SKNMIPSA/elektronicy-p-lodz-pl-2018/_PHOTOS/bottom.jpg

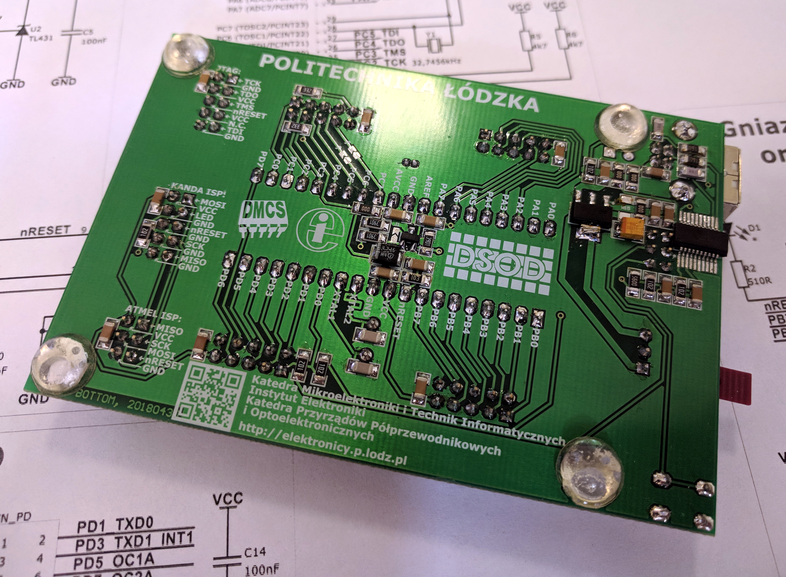
_PHOTOS/bottom.jpg
