SKNMIPSA/elektronicy-p-lodz-pl-2018/_PHOTOS/top1.jpg

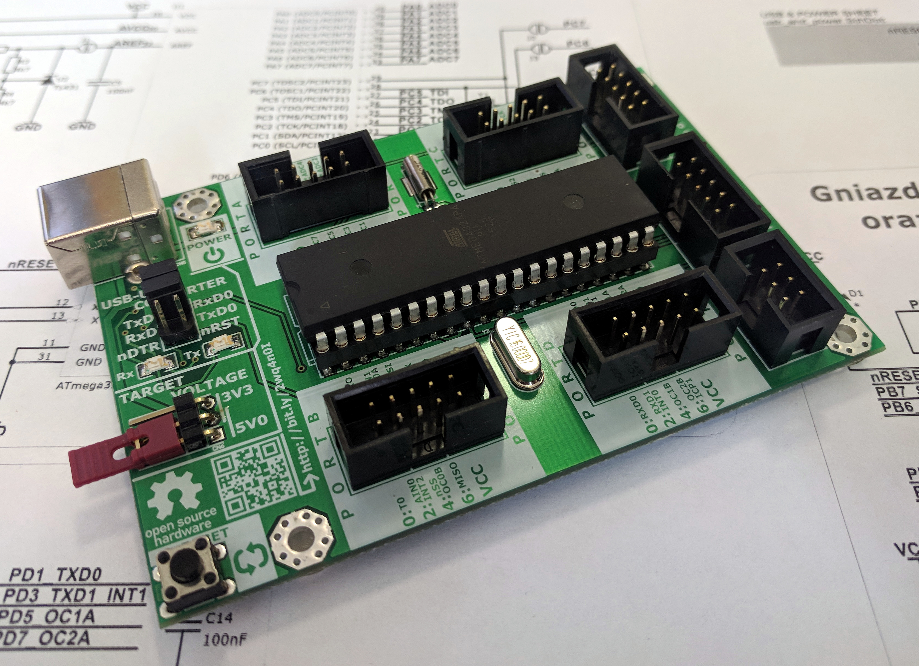
_PHOTOS/top1.jpg
