SKNMIPSA/elektronicy-p-lodz-pl-2018/README.md

# elektronicy-p-lodz-pl-2018
Płytka prototypowa rozdawana podczas wydarzenia 'Elektronicy dla studentów': IE, DMCS i DSOD PŁ - 2018
