SKNMIPSA/elektronicy-p-lodz-pl-2018/_PHOTOS/top2.jpg

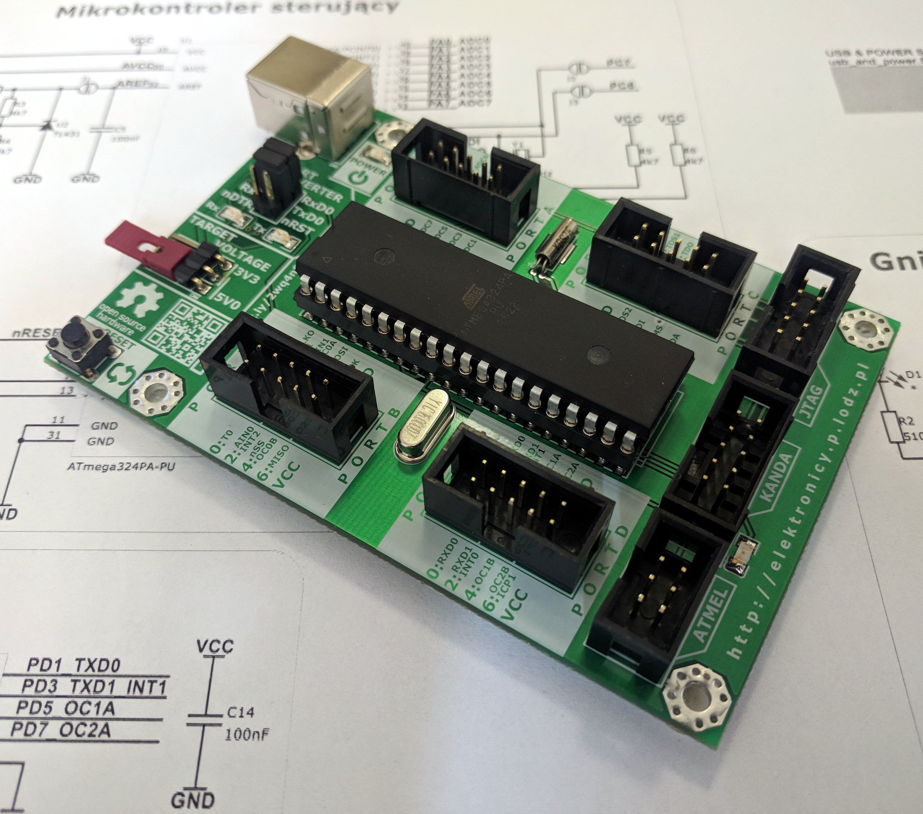
_PHOTOS/top2.jpg
