SKNMIPSA/elektronicy-p-lodz-pl-2018/_PHOTOS/top3.jpg

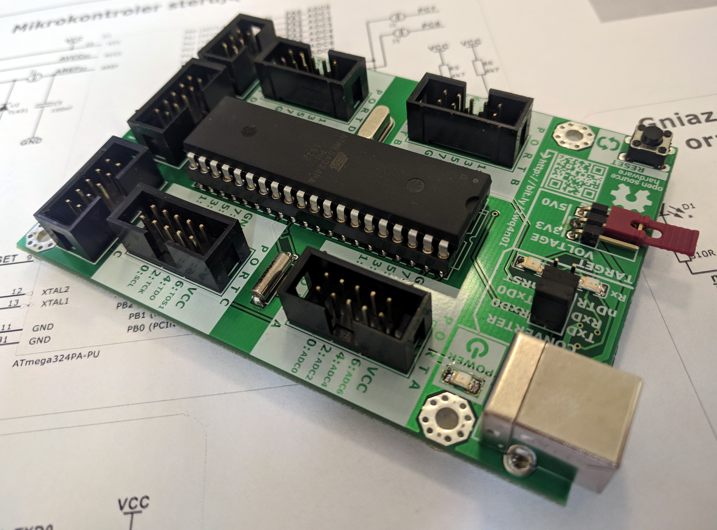
_PHOTOS/top3.jpg
