SKNMIPSA/elektronicy-p-lodz-pl-2018/_PHOTOS/top4.jpg

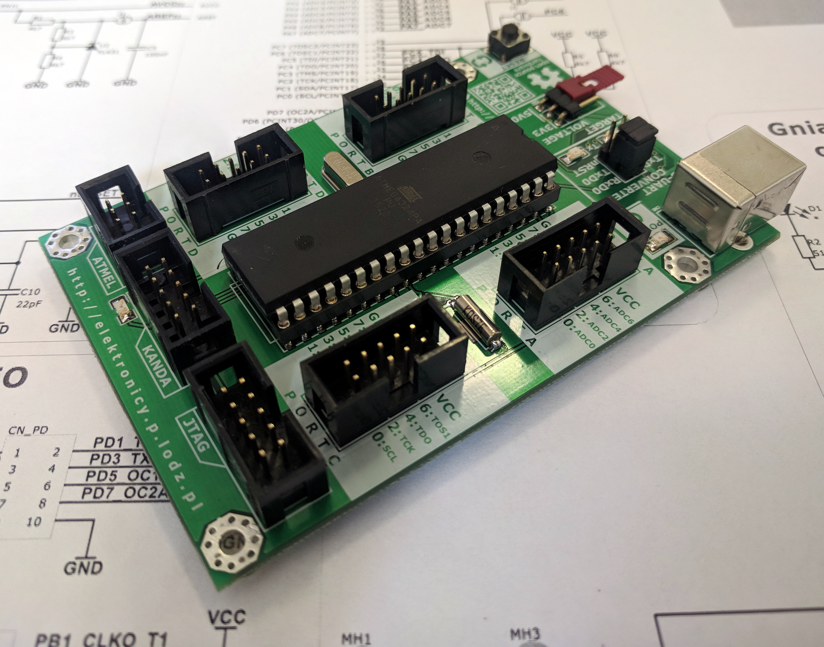
_PHOTOS/top4.jpg
