SKNMIPSA/elektronicy-p-lodz-pl-2018/bottom.png

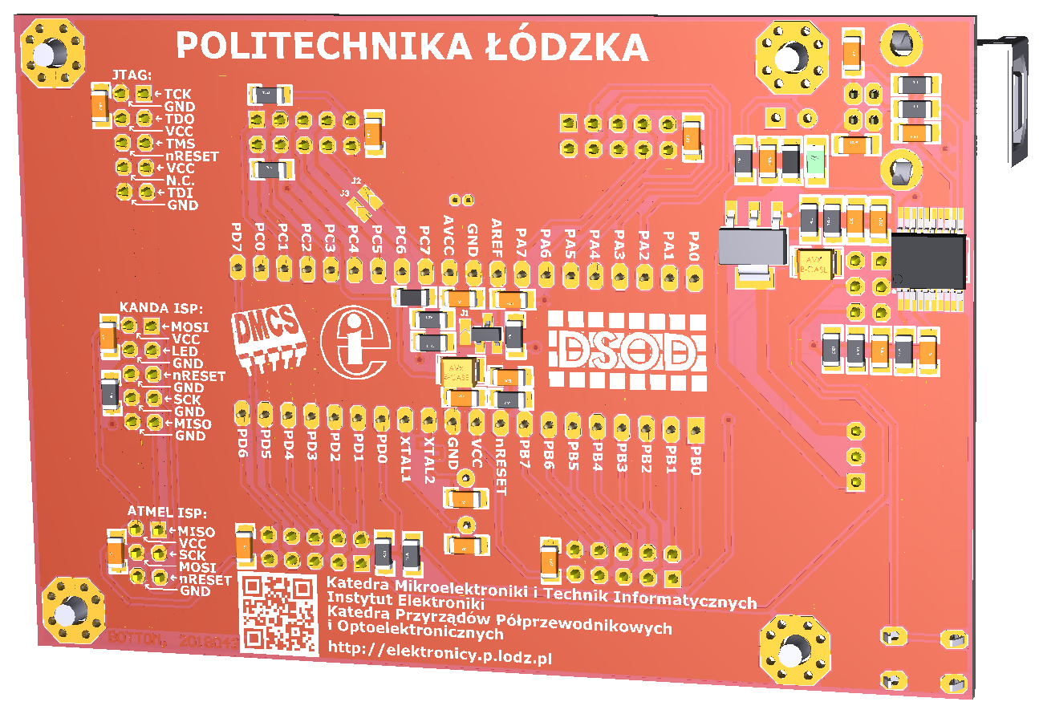
bottom.png
