SKNMIPSA/elektronicy-p-lodz-pl-2018/top.png

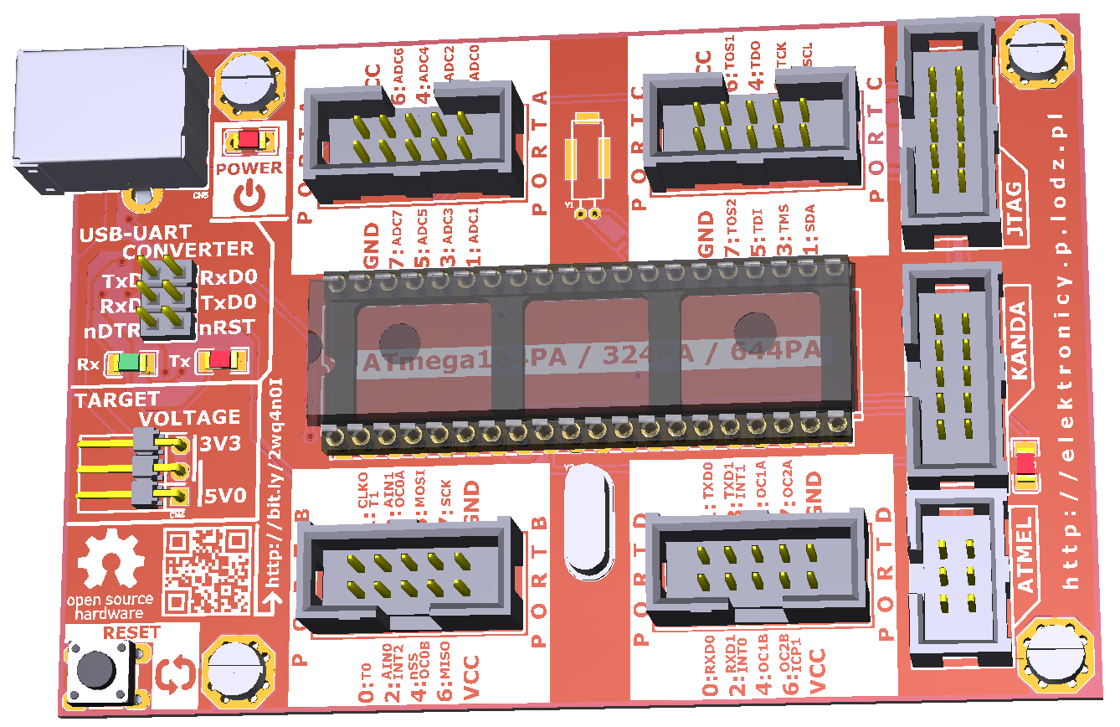
top.png
