SKNMIPSA/elektronicy-p-lodz-pl-2018/_DOCUMENTATION/sch, elektronicy-p-lodz-pl-B-2018, FULL.pdf

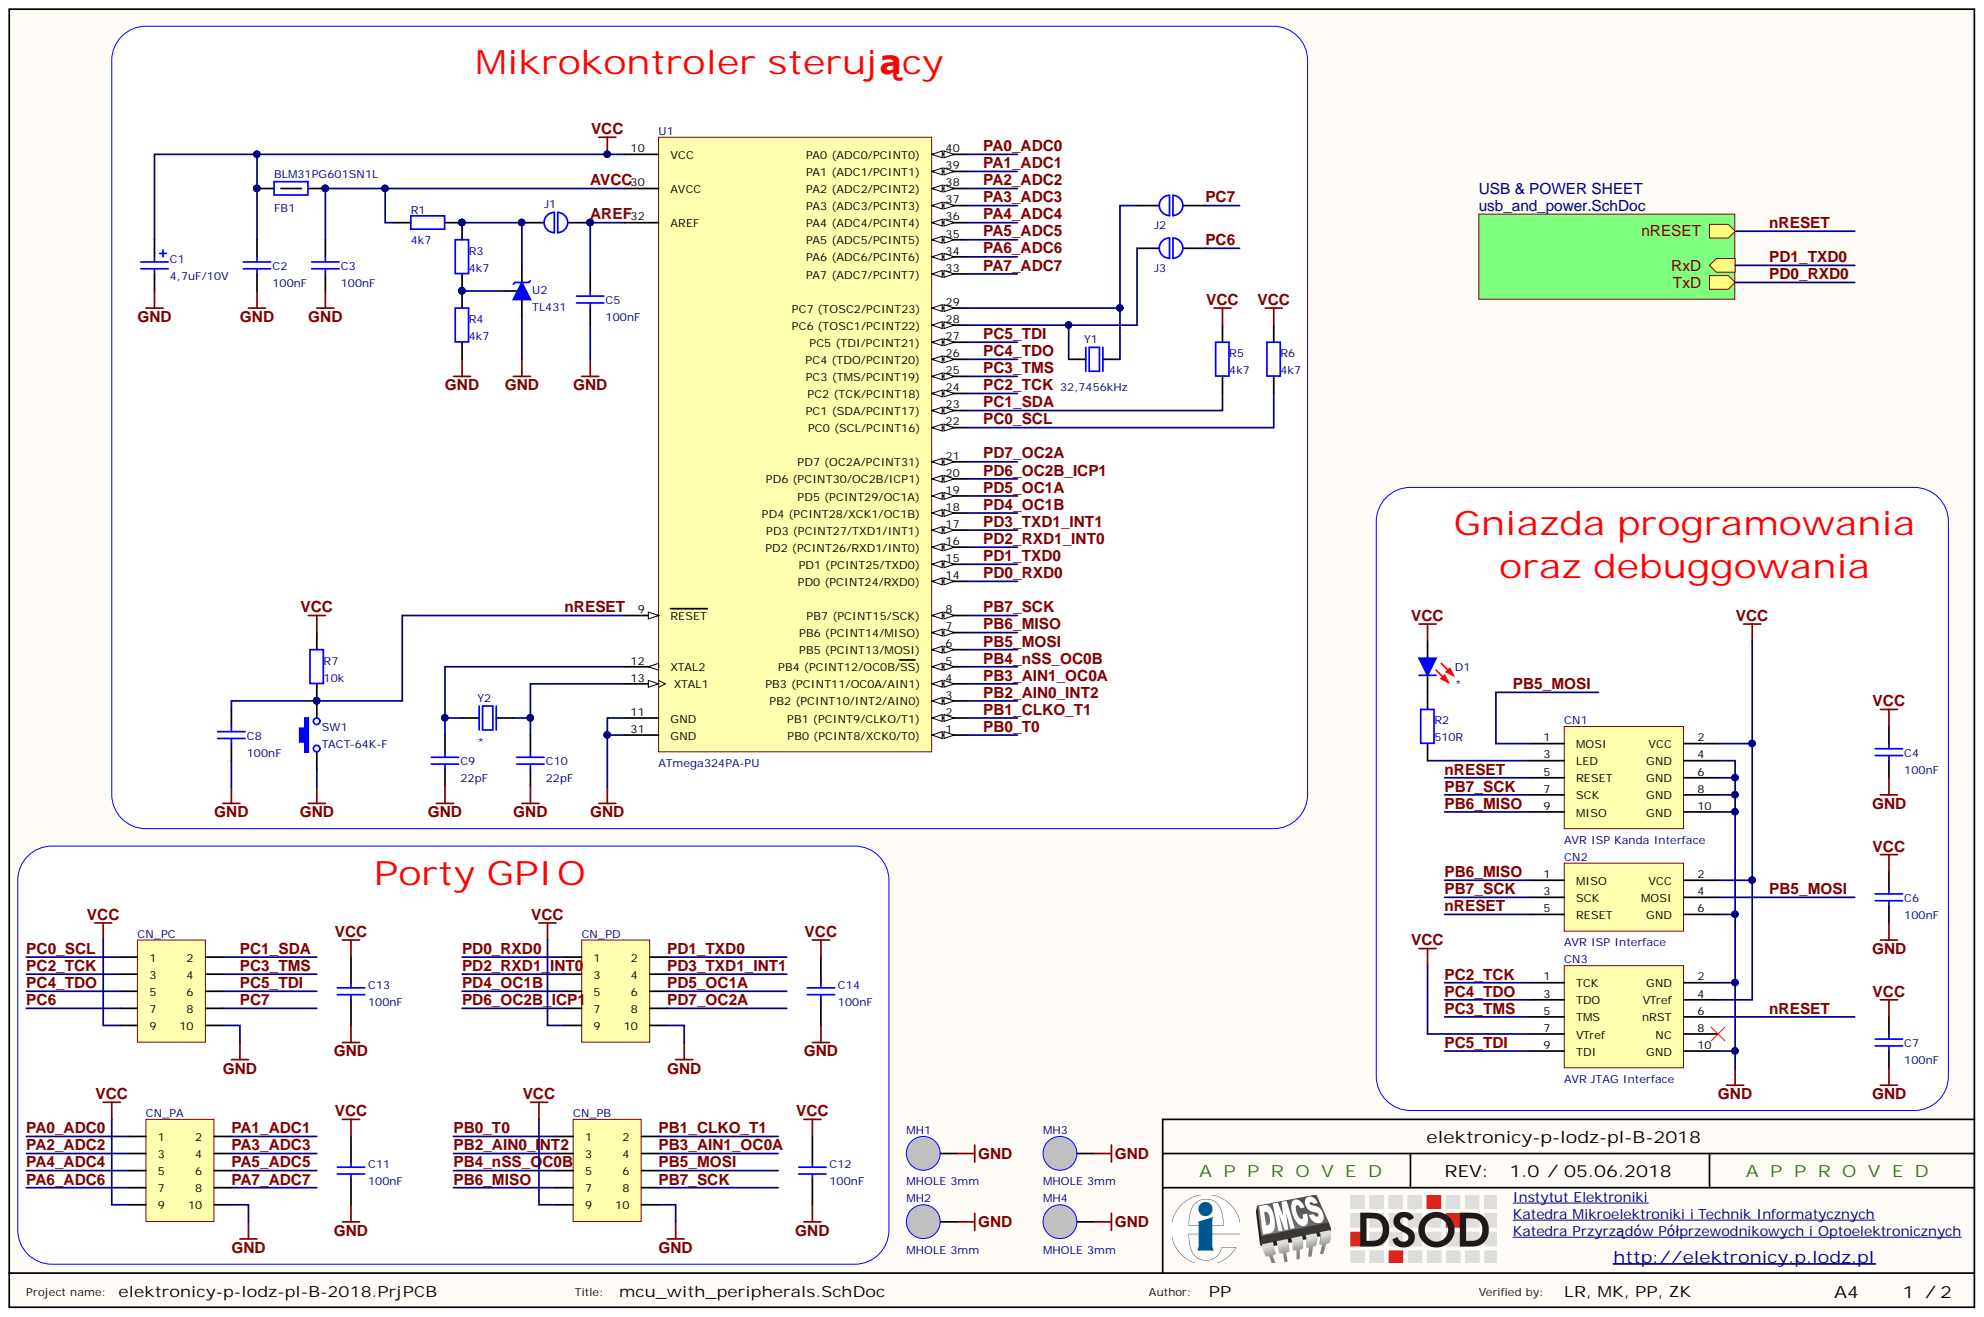
[picture p15: page 1]

Instytut Elektroniki Katedra Mikroelektroniki i Technik Informatycznych Katedra Przyrządów Półprzewodnikowych i Optoelektronicznych

http://elektronicy.p.lodz.pl

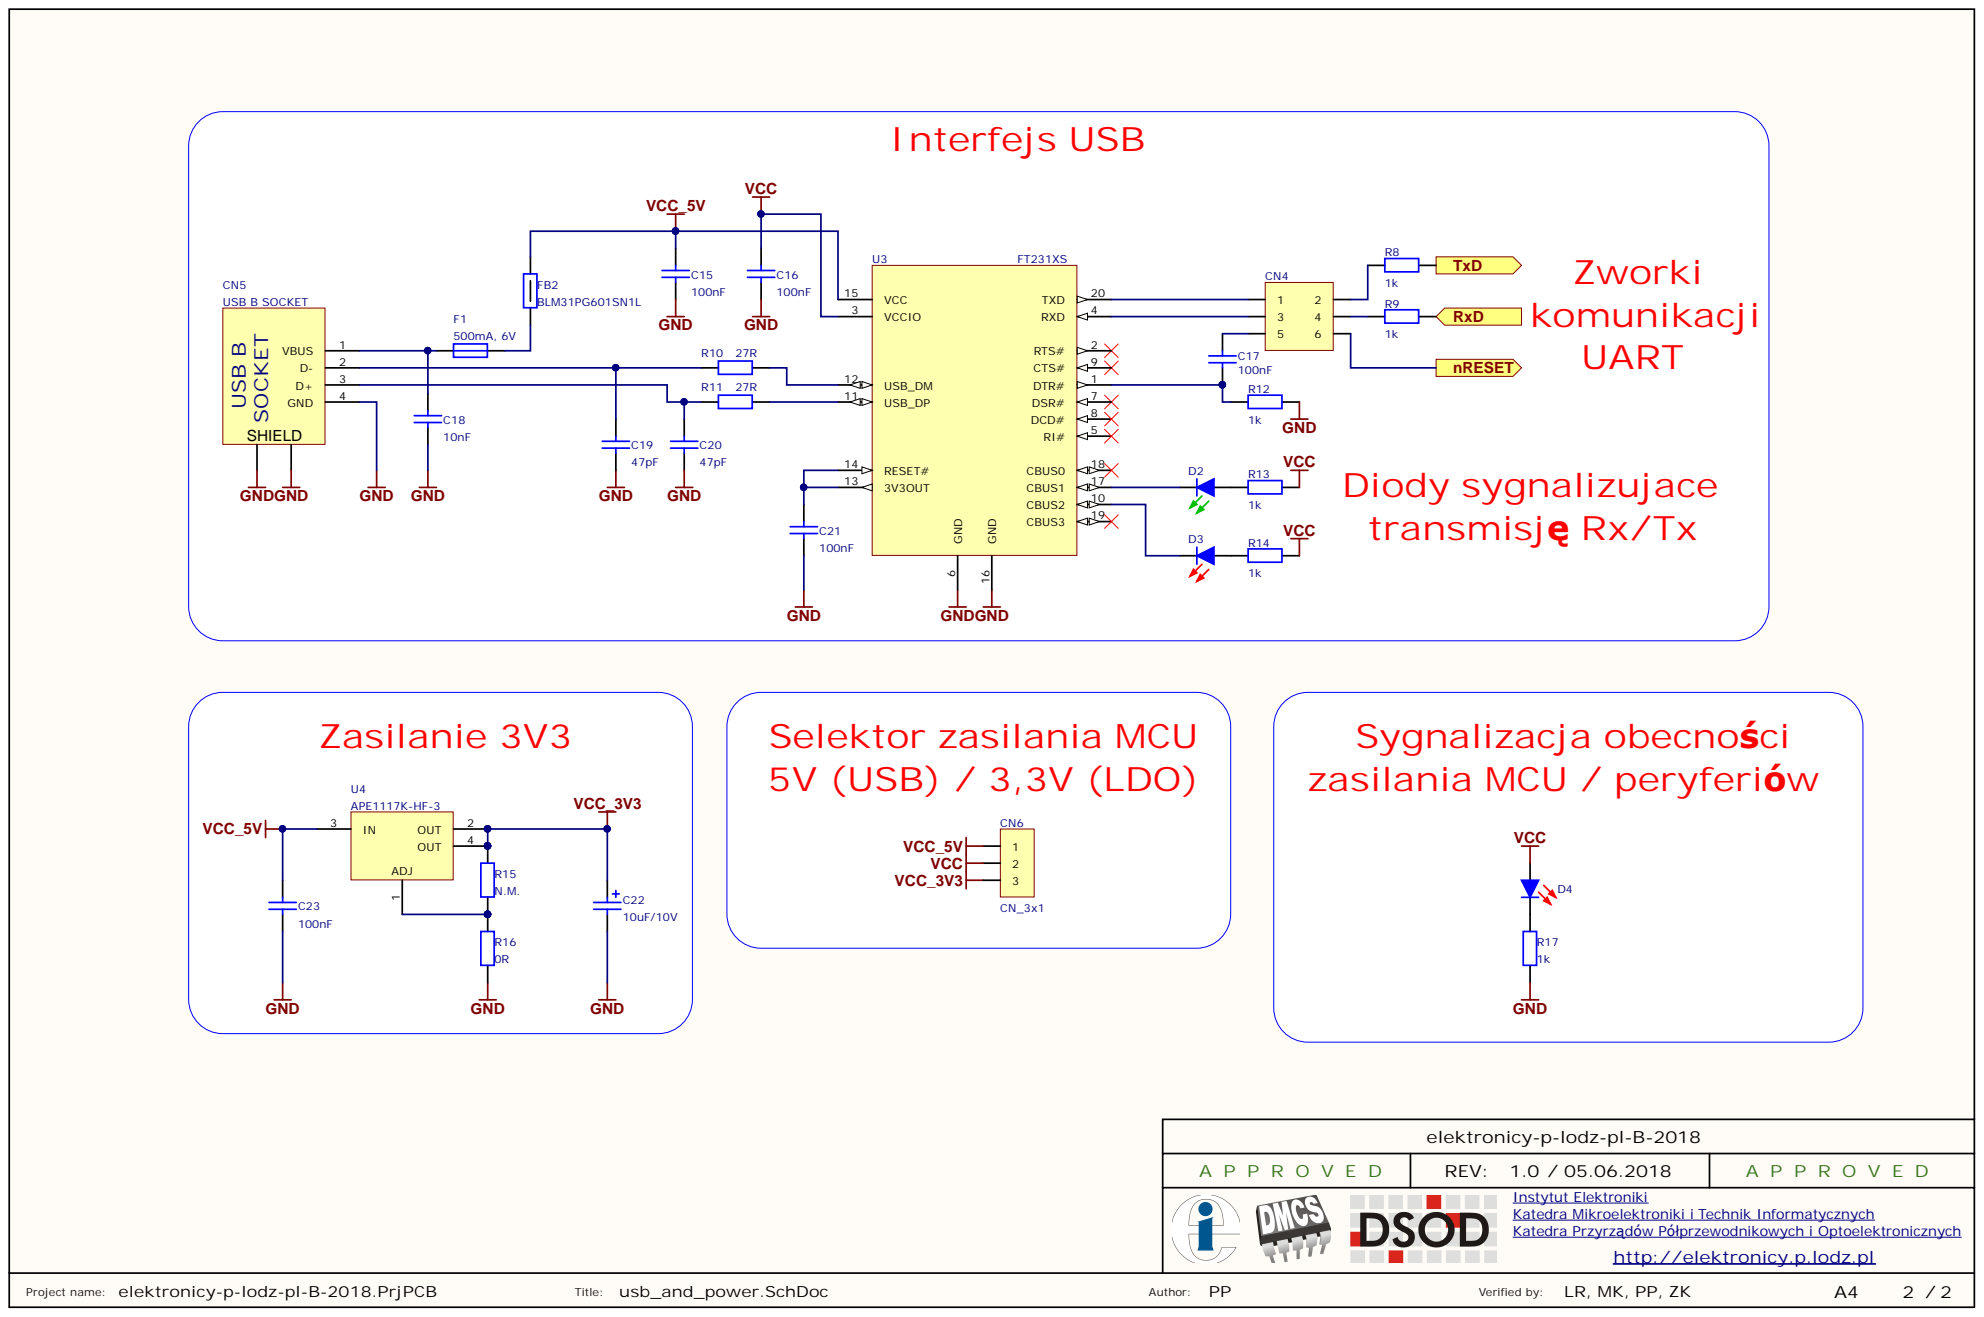
[picture p16: page 2]

Instytut Elektroniki
Katedra Mikroelektroniki i Technik Informatycznych
Katedra Przyrządów Półprzewodnikowych i Optoelektronicznych

http://elektronicy.p.lodz.pl
