SKNMIPSA/elektronicy-p-lodz-pl-2018/(list of files, drawings)

Other design files:
elektronicy-p-lodz-pl-B-2018.PrjPCB
mcu_with_peripherals.SchDoc
pcb.PcbDoc
usb_and_power.SchDoc
