SKNMIPSA/elektronicy-p-lodz-pl-2018/(commit log)

2018-04-27 pierwsza wersja robocza, placement złącz
    [elektronicy-p-lodz-pl-2018.PrjPCB, mcu_with_peripherals.SchDoc, pcb.PcbDoc, usb_and_power.SchDoc]
2018-04-27 kody QR, opisy złącz programowania + pinów MCU
    [elektronicy-p-lodz-pl-2018.PrjPCB, pcb.PcbDoc]
2018-04-29 logotyp DSOD i uzupełnienia
    [elektronicy-p-lodz-pl-2018.PrjPCB, mcu_with_peripherals.SchDoc, pcb.PcbDoc, usb_and_power.SchDoc]
2018-04-30 zmiany diod na SMD, kolejny etap prac
    [pcb.PcbDoc, usb_and_power.SchDoc]
2018-04-30 referencja na MCU, placement
    [mcu_with_peripherals.SchDoc, pcb.PcbDoc, usb_and_power.SchDoc]
2018-05-02 poprawki i routing
    [mcu_with_peripherals.SchDoc, pcb.PcbDoc]
2018-05-02 routing i opisy
    [mcu_with_peripherals.SchDoc, pcb.PcbDoc]
2018-05-04 ostateczny (?) placement
    [pcb.PcbDoc]
2018-05-06 zmiana szablonów + polygin i delikatne zmiany opisów na BOTTOM, do dyskusji
    [mcu_with_peripherals.SchDoc, pcb.PcbDoc, usb_and_power.SchDoc]
2018-05-08 reannotation, update warstwy opisowej wg uwag ze spotkania
    [elektronicy-p-lodz-pl-2018.PrjPCB, mcu_with_peripherals.SchDoc, pcb.PcbDoc, usb_and_power.SchDoc]
2018-05-10 ostatnie poprawki PCB oraz pliki wysłane do wyceny
    [elektronicy-p-lodz-pl-B-2018-v10.DRL, elektronicy-p-lodz-pl-B-2018-v10.GBL, elektronicy-p-lodz-pl-B-2018-v10.GBO, elektronicy-p-lodz-pl-B-2018-v10.GBP, elektronicy-p-lodz-pl-B-2018-v10.GBS, elektronicy-p-lodz-pl-B-2018-v10.GKO, elektronicy-p-lodz-pl-B-2018-v10.GTL, elektronicy-p-lodz-pl-B-2018-v10.GTO]
2018-05-13 update po uwagach z BaZeKo
    [elektronicy-p-lodz-pl-B-2018.PrjPCB, pcb.PcbDoc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]
2018-05-28 porządki i nowe rendery płytki
    [elektronicy-p-lodz-pl-2018.PrjPCB, elektronicy-p-lodz-pl-B-2018.PrjPCB, pcb.PcbDoc]
2018-06-02 porządki w schemacie (w trakcie składania płytki)
    [elektronicy-p-lodz-pl-B-2018.PrjPCB, mcu_with_peripherals.SchDoc, pcb.PcbDoc, usb_and_power.SchDoc]
2018-06-04 porządki na schematach, BOM i dokumentacje PDF
    [bom, elektronicy-p-lodz-pl-B-2018.xls, elektronicy-p-lodz-pl-B-2018.PrjPCB, mcu_with_peripherals.SchDoc, pcb.PcbDoc, usb_and_power.SchDoc]
2018-06-04 korekta R7 w BOMie
    [bom, elektronicy-p-lodz-pl-B-2018.xls]
2018-06-05 poprawka dokumentacji wg uwag MK
    [bom, elektronicy-p-lodz-pl-B-2018.xls]
2018-06-05 zdjęcia płytki i szlify dokumentacji
    [elektronicy-p-lodz-pl-B-2018.PrjPCB, mcu_with_peripherals.SchDoc]
